xialing95/Open_modem_60Khz/README.md

# Open_Modem
Future Ocean Lab Open Modem Project - Low cost underwater acoustic modem

Documentation: https://dspace.mit.edu/handle/1721.1/130598?show=full
