xialing95/Open_modem_60Khz/OpenModem V2/OpenModemV2_rx.brd

## EAGLE design OpenModem V2/OpenModemV2_rx.brd (2023-05-25)

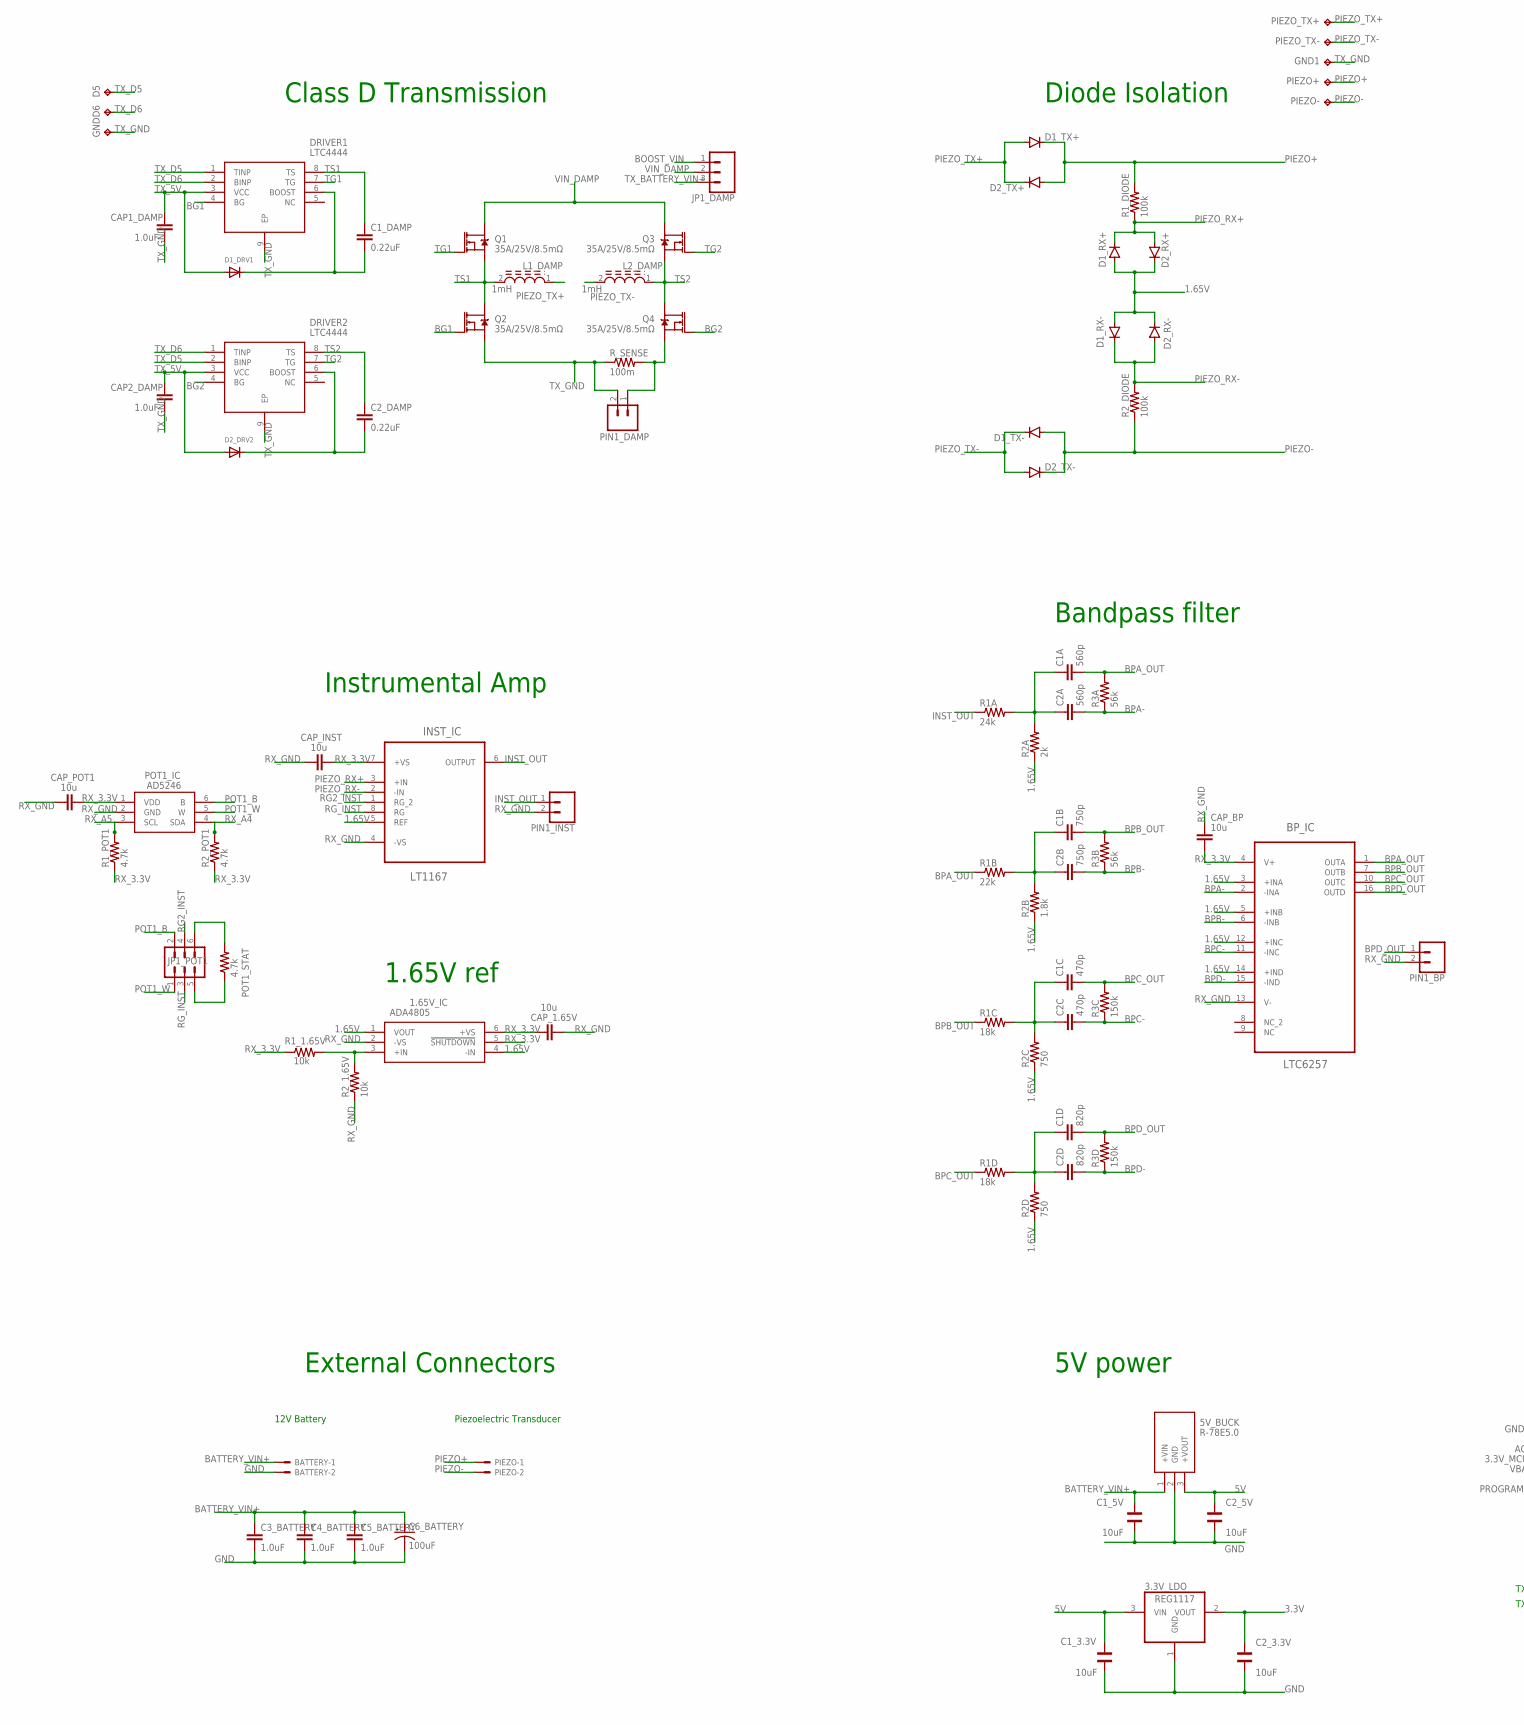
[picture p1: schematic OpenModemV2_rx.sch, sheet 1, part in row 1, column 1]

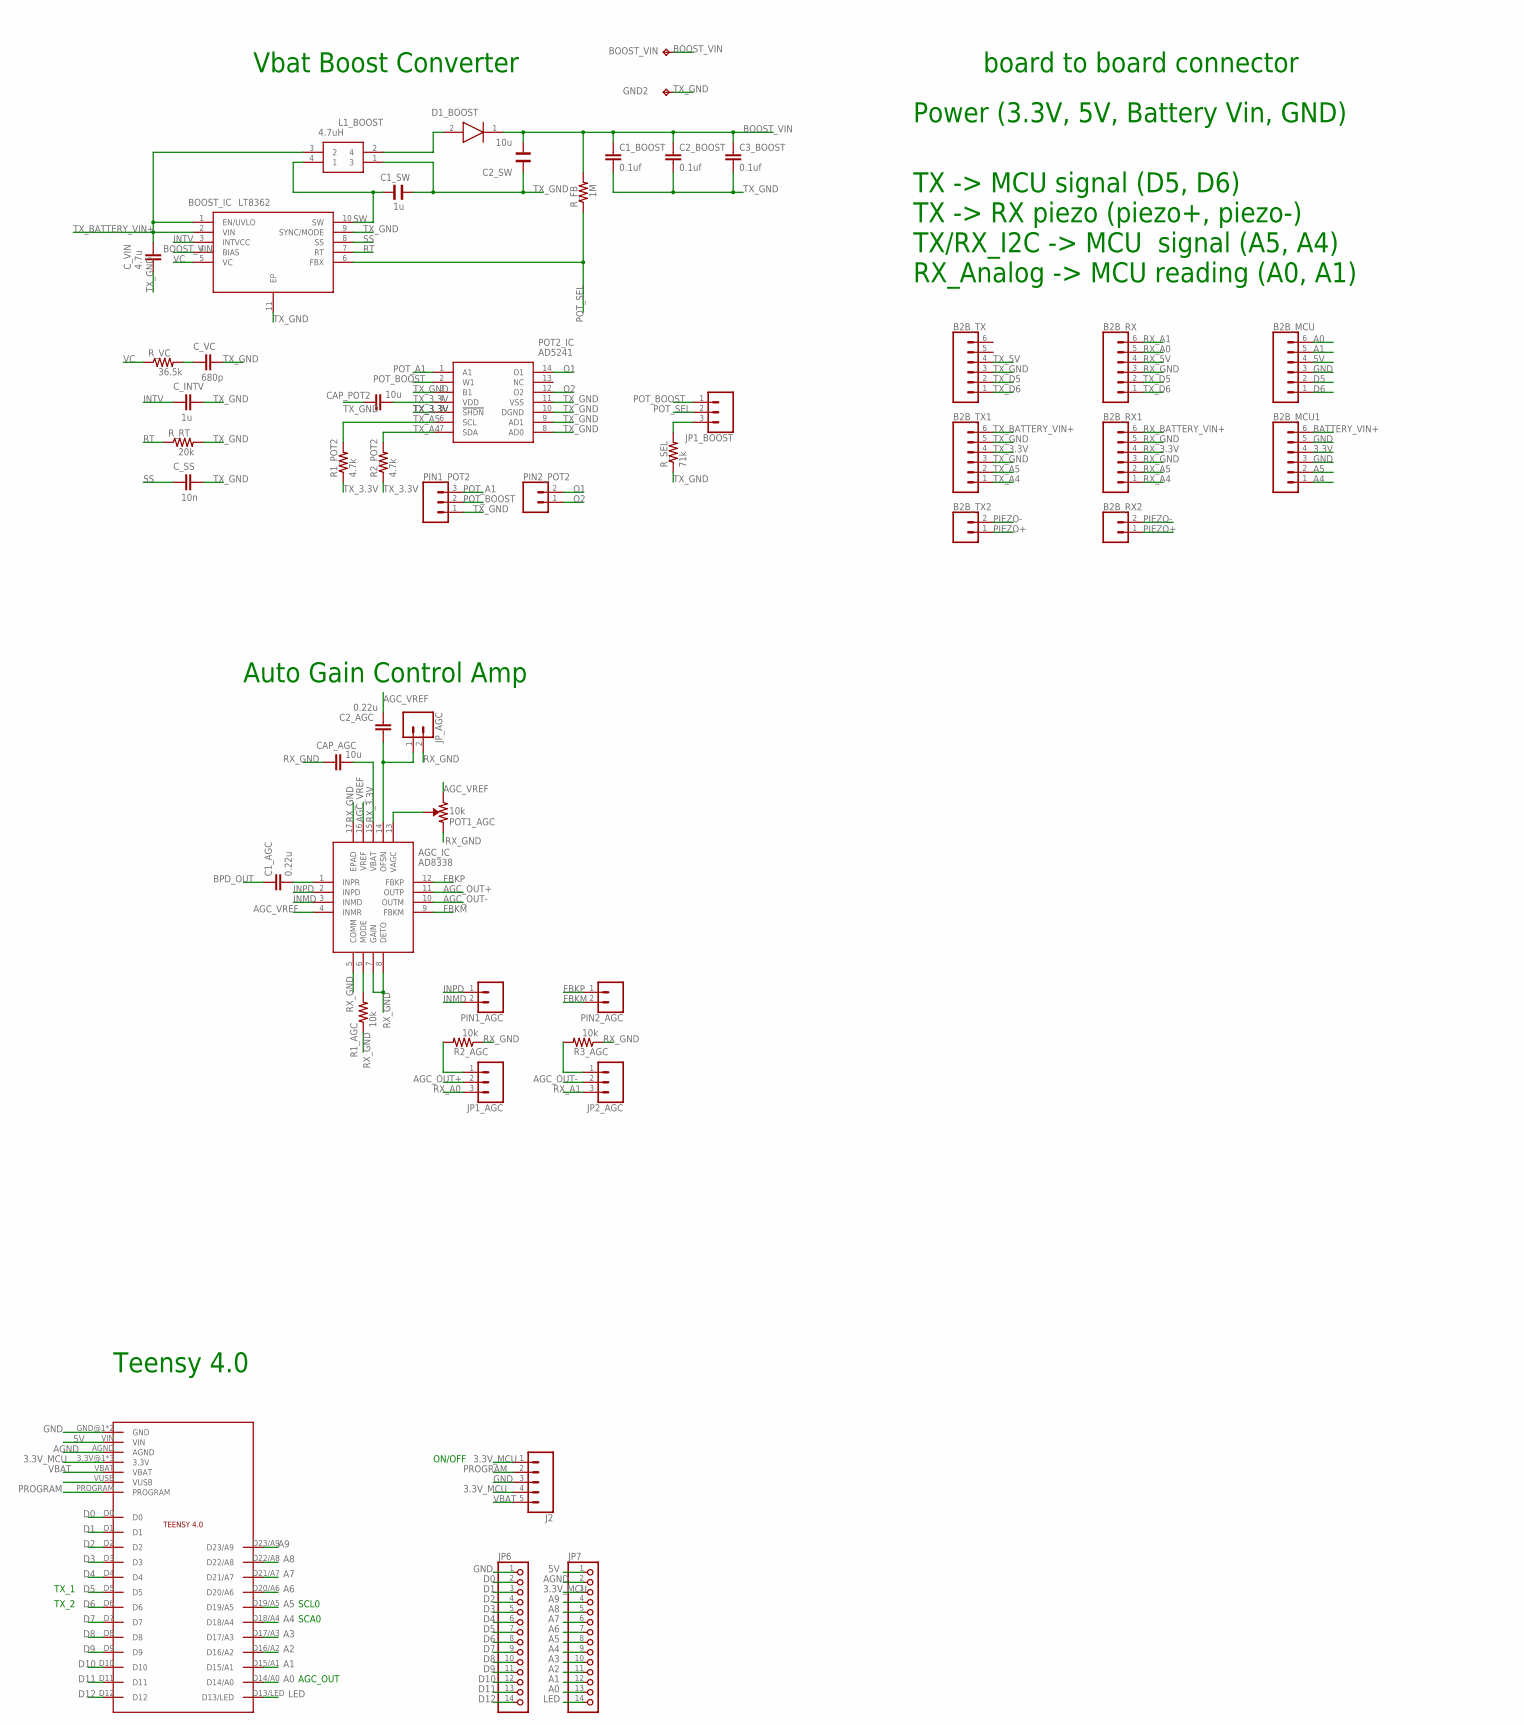
[picture p2: schematic OpenModemV2_rx.sch, sheet 1, part in row 1, column 2]

Parts:
1.65V_IC: ADA4805; SOT95P280X145-6N
3.3V_LDO: REG1117; SOT223
5V_BUCK: R-78E5.0; R-78E5.0-1.0
AGC_IC: AD8338; QFN50P300X300X80-17N
B2B_MCU, B2B_MCU1, B2B_RX, B2B_RX1, B2B_TX, B2B_TX1: CONN_06SILK_FEMALE_PTH; 1X06
B2B_RX2, B2B_TX2: CONN_02; 1X02
BATTERY: 22-27-2021-02; 6410-02
BOOST_IC: LT8362; SON50P300X300X80-11N
BOOST_VIN: TPPAD1-13; P1-13
BP_IC: LTC6257; SOP50P490X110-16N
C1A, C2A: 560p; C0402
C1B, C2B: 750p; C0402
C1C, C2C: 470p; C0402
C1D, C2D: 820p; C0402
C1_3.3V, C1_5V, C2_3.3V, C2_5V: 10uF; WCAP-CSGP_0603_REFLOW
C1_AGC, C2_AGC: 0.22u; C0402
C1_BOOST, C2_BOOST, C3_BOOST: 0.1uf; 0805
C1_DAMP, C2_DAMP: 0.22uF; 0603
C1_SW: 1u; WCAP-CSGP_1206
C2_SW: 10u; WCAP-CSGP_1206
C3_BATTERY, C4_BATTERY, C5_BATTERY: 1.0uF; 0805
C6_BATTERY: 100uF; PANASONIC_D
CAP1_DAMP, CAP2_DAMP: 1.0uF; 0603
CAP_1.65V: 10u; C0402
CAP_AGC: 10u; C0402
CAP_BP: 10u; C0402
CAP_INST: 10u; C0402
CAP_POT1, CAP_POT2: 10u; C0402
C_INTV: 1u; C0402
C_SS: 10n; C0402
C_VC: 680p; C0402
C_VIN: 4.7u; C0402
D1_BOOST: DFLS260-7; POWERDI123
D1_DRV1, D2_DRV2: DIODESOD-323F; SOD-323F
D1_RX+, D1_RX-, D1_TX+, D1_TX-, D2_RX+, D2_RX-, D2_TX+, D2_TX-: DIODE-SOD523; SOD523
D5, D6: TPPAD1-13; P1-13
DRIVER1, DRIVER2: LTC4444; SOP65P490X110-9N
GND, GND1, GND2: TPPAD1-13; P1-13
INST_IC: LT1167; SOIC127P600X175-8N
J2: CONN_05; 1X05
JP1_AGC, JP1_BOOST, JP1_DAMP, JP2_AGC: CONN_03; 1X03
JP1_POT1: CONN_03X2NO_SILK; 2X3-NS
JP6, JP7: PINHD-1X14-CB; 1X14-CB
JP_AGC: CONN_02; 1X02
L1_BOOST: 4.7uH; WE-DD_7332/734512
L1_DAMP, L2_DAMP: 1mH; INDP125125X600N
PIEZO: 22-27-2021-02; 6410-02
PIEZO+: TPPAD1-13; P1-13
PIEZO-: TPPAD1-13; P1-13
PIEZO_TX+: TPPAD1-13; P1-13
PIEZO_TX-: TPPAD1-13; P1-13
PIN1_AGC, PIN1_BP, PIN1_DAMP, PIN1_INST, PIN2_AGC, PIN2_POT2: CONN_02; 1X02
PIN1_POT2: CONN_03; 1X03
POT1_AGC: 10k; TRIMPOT-SMD-3MM-CLOSED
POT1_IC: AD5246; SOT65P210X110-6N
POT1_STAT: 4.7k; R0603
POT2_IC: AD5241; SOP65P640X120-14N
Q1, Q2, Q3, Q4: 35A/25V/8.5mΩ; DPAK
R1A: 24k; R0603
R1B: 22k; R0603
R1C, R1D: 18k; R0603
R1_1.65V, R1_AGC, R2_1.65V, R2_AGC, R3_AGC: 10k; R0603
R1_DIODE, R2_DIODE: 100k; R0603
R1_POT1, R1_POT2, R2_POT1, R2_POT2: 4.7k; R0603
R2A: 2k; R0603
R2B: 1.8k; R0603
R2C, R2D: 750; R0603
R3A, R3B: 56k; R0603
R3C, R3D: 150k; R0603
R_FB: 1M; R0603
R_RT: 20k; R0603
R_SEL: 71k; R0603
R_SENSE: 100m; M1206
R_VC: 36.5k; R0603
U$1: TEENSY4.0

Connections:
1.65V: 1.65V_IC.1 (VOUT), 1.65V_IC.4 (-IN), BP_IC.3 (+INA), BP_IC.5 (+INB), BP_IC.12 (+INC), BP_IC.14 (+IND), D1_RX+.A, D1_RX-.A, D2_RX+.C, D2_RX-.C, INST_IC.5 (REF), R2A.1, R2B.1, R2C.1, R2D.1
3.3V: 3.3V_LDO.2 (VOUT), B2B_MCU1.4, C2_3.3V.2
3.3V_MCU: J2.1, J2.4, JP7.3, U$1.3.3V@1 (3.3V), U$1.3.3V@2 (3.3V), U$1.ON/OFF (3.3V)
5V: 3.3V_LDO.3 (VIN), 5V_BUCK.3 (+VOUT), B2B_MCU.4, C1_3.3V.2, C2_5V.2, JP7.1, U$1.VIN
A0: B2B_MCU.6, JP7.13, U$1.D14/A0
A1: B2B_MCU.5, JP7.12, U$1.D15/A1
A2: JP7.11, U$1.D16/A2
A3: JP7.10, U$1.D17/A3
A4: B2B_MCU1.1, JP7.9, U$1.D18/A4
A5: B2B_MCU1.2, JP7.8, U$1.D19/A5
A6: JP7.7, U$1.D20/A6
A7: JP7.6, U$1.D21/A7
A8: JP7.5, U$1.D22/A8
A9: JP7.4, U$1.D23/A9
AGC_OUT+: AGC_IC.11 (OUTP), JP1_AGC.2
AGC_OUT-: AGC_IC.10 (OUTM), JP2_AGC.2
AGC_VREF: AGC_IC.4 (INMR), AGC_IC.16 (VREF), C2_AGC.2, POT1_AGC.3 (CW)
AGND: JP7.2, U$1.AGND
BATTERY_VIN+: 5V_BUCK.1 (+VIN), B2B_MCU1.6, BATTERY.1, C1_5V.1, C3_BATTERY.1, C4_BATTERY.1, C5_BATTERY.1, C6_BATTERY.+
BG1: DRIVER1.4 (BG), Q2.1 (G)
BG2: DRIVER2.4 (BG), Q4.1 (G)
BOOST_VIN: BOOST_IC.4 (BIAS), BOOST_VIN.TP, C1_BOOST.1, C2_BOOST.1, C2_SW.1, C3_BOOST.1, D1_BOOST.1 (K), JP1_DAMP.1, R_FB.2
BPA-: BP_IC.2 (-INA), C2A.2, R3A.1
BPA_OUT: BP_IC.1 (OUTA), C1A.2, R1B.1, R3A.2
BPB-: BP_IC.6 (-INB), C2B.2, R3B.1
BPB_OUT: BP_IC.7 (OUTB), C1B.2, R1C.1, R3B.2
BPC-: BP_IC.11 (-INC), C2C.2, R3C.1
BPC_OUT: BP_IC.10 (OUTC), C1C.2, R1D.1, R3C.2
BPD-: BP_IC.15 (-IND), C2D.2, R3D.1
BPD_OUT: BP_IC.16 (OUTD), C1D.2, C1_AGC.1, PIN1_BP.1, R3D.2
D0: JP6.2, U$1.D0
D1: JP6.3, U$1.D1
D2: JP6.4, U$1.D2
D3: JP6.5, U$1.D3
D4: JP6.6, U$1.D4
D5: B2B_MCU.2, JP6.7, U$1.D5
D6: B2B_MCU.1, JP6.8, U$1.D6
D7: JP6.9, U$1.D7
D8: JP6.10, U$1.D8
D9: JP6.11, U$1.D9
D10: JP6.12, U$1.D10
D11: JP6.13, U$1.D11
D12: JP6.14, U$1.D12
FBKM: AGC_IC.9 (FBKM), PIN2_AGC.2
FBKP: AGC_IC.12 (FBKP), PIN2_AGC.1
GND: 3.3V_LDO.1 (GND), 5V_BUCK.2 (GND), B2B_MCU.3, B2B_MCU1.3, B2B_MCU1.5, BATTERY.2, C1_3.3V.1, C1_5V.2, C2_3.3V.1, C2_5V.1, C3_BATTERY.2, C4_BATTERY.2, C5_BATTERY.2, C6_BATTERY.-, J2.3, JP6.1, U$1.GND@1 (GND), U$1.GND@2 (GND)
INMD: AGC_IC.3 (INMD), PIN1_AGC.2
INPD: AGC_IC.2 (INPD), PIN1_AGC.1
INST_OUT: INST_IC.6 (OUTPUT), PIN1_INST.1, R1A.1
INTV: BOOST_IC.3 (INTVCC), C_INTV.2
LED: JP7.14, U$1.D13/LED
unnamed: C1_DAMP.2, D1_DRV1.C, DRIVER1.6 (BOOST)
unnamed: C2_DAMP.2, D2_DRV2.C, DRIVER2.6 (BOOST)
unnamed: JP1_POT1.6, POT1_STAT.2
unnamed: C1A.1, C2A.1, R1A.2, R2A.2
unnamed: C1B.1, C2B.1, R1B.2, R2B.2
unnamed: C1C.1, C2C.1, R1C.2, R2C.2
unnamed: C1D.1, C2D.1, R1D.2, R2D.2
unnamed: C_VC.2, R_VC.2
unnamed: AGC_IC.6 (MODE), R1_AGC.2
unnamed: 1.65V_IC.3 (+IN), R1_1.65V.2, R2_1.65V.2
unnamed: AGC_IC.1 (INPR), C1_AGC.2
unnamed: JP1_POT1.5, POT1_STAT.1
unnamed: JP1_AGC.1, R2_AGC.2
unnamed: JP2_AGC.1, R3_AGC.2
unnamed: AGC_IC.14 (OFSN), C2_AGC.1, JP_AGC.1
unnamed: AGC_IC.13 (VAGC), POT1_AGC.2 (WIPER)
unnamed: PIN1_DAMP.1, Q4.3 (S), R_SENSE.2
unnamed: D1_BOOST.2 (A), L1_BOOST.2 (4)
unnamed: JP1_BOOST.3, R_SEL.2
O1: PIN2_POT2.2, POT2_IC.14 (O1)
O2: PIN2_POT2.1, POT2_IC.12 (O2)
PIEZO+: B2B_RX2.1, B2B_TX2.1, D1_TX+.C, D2_TX+.A, PIEZO.1, PIEZO+.TP, R1_DIODE.2
PIEZO-: B2B_RX2.2, B2B_TX2.2, D1_TX-.A, D2_TX-.C, PIEZO.2, PIEZO-.TP, R2_DIODE.1
PIEZO_RX+: D1_RX+.C, D2_RX+.A, INST_IC.3 (+IN), R1_DIODE.1
PIEZO_RX-: D1_RX-.C, D2_RX-.A, INST_IC.2 (-IN), R2_DIODE.2
PIEZO_TX+: D1_TX+.A, D2_TX+.C, L1_DAMP.1, PIEZO_TX+.TP
PIEZO_TX-: D1_TX-.C, D2_TX-.A, L2_DAMP.2, PIEZO_TX-.TP
POT1_B: JP1_POT1.2, POT1_IC.6 (B)
POT1_W: JP1_POT1.1, POT1_IC.5 (W)
POT_A1: PIN1_POT2.3, POT2_IC.1 (A1)
POT_BOOST: JP1_BOOST.1, PIN1_POT2.2, POT2_IC.2 (W1)
POT_SEL: BOOST_IC.6 (FBX), JP1_BOOST.2, R_FB.1
PROGRAM: J2.2, U$1.PROGRAM
RG2_INST: INST_IC.1 (RG_2), JP1_POT1.4
RG_INST: INST_IC.8 (RG), JP1_POT1.3
RT: BOOST_IC.7 (RT), R_RT.1
RX_3.3V: 1.65V_IC.5 (!SHUTDOWN), 1.65V_IC.6 (+VS), AGC_IC.15 (VBAT), B2B_RX1.4, BP_IC.4 (V+), CAP_1.65V.2, CAP_AGC.1, CAP_BP.1, CAP_INST.2, CAP_POT1.2, INST_IC.7 (+VS), POT1_IC.1 (VDD), R1_1.65V.1, R1_POT1.1, R2_POT1.1
RX_5V: B2B_RX.4
RX_A0: B2B_RX.5, JP1_AGC.3
RX_A1: B2B_RX.6, JP2_AGC.3
RX_A4: B2B_RX1.1, POT1_IC.4 (SDA), R2_POT1.2
RX_A5: B2B_RX1.2, POT1_IC.3 (SCL), R1_POT1.2
RX_BATTERY_VIN+: B2B_RX1.6
RX_GND: 1.65V_IC.2 (-VS), AGC_IC.5 (COMM), AGC_IC.7 (GAIN), AGC_IC.8 (DETO), AGC_IC.17 (EPAD), B2B_RX.3, B2B_RX1.3, B2B_RX1.5, BP_IC.13 (V-), CAP_1.65V.1, CAP_AGC.2, CAP_BP.2, CAP_INST.1, CAP_POT1.1, INST_IC.4 (-VS), JP_AGC.2, PIN1_BP.2, PIN1_INST.2, POT1_AGC.1 (CCW), POT1_IC.2 (GND), R1_AGC.1, R2_1.65V.1, R2_AGC.1, R3_AGC.1
SS: BOOST_IC.8 (SS), C_SS.2
SW: BOOST_IC.10 (SW), C1_SW.2, L1_BOOST.4 (1)
TG1: DRIVER1.7 (TG), Q1.1 (G)
TG2: DRIVER2.7 (TG), Q3.1 (G)
TS1: C1_DAMP.1, DRIVER1.8 (TS), L1_DAMP.2, Q1.3 (S), Q2.4 (D)
TS2: C2_DAMP.1, DRIVER2.8 (TS), L2_DAMP.1, Q3.3 (S), Q4.4 (D)
TX_3.3V: B2B_TX1.4, CAP_POT2.1, POT2_IC.4 (VDD), POT2_IC.5 (!SHDN), R1_POT2.1, R2_POT2.1
TX_5V: B2B_TX.4, CAP1_DAMP.1, CAP2_DAMP.1, D1_DRV1.A, D2_DRV2.A, DRIVER1.3 (VCC), DRIVER2.3 (VCC)
TX_A4: B2B_TX1.1, POT2_IC.7 (SDA), R2_POT2.2
TX_A5: B2B_TX1.2, POT2_IC.6 (SCL), R1_POT2.2
TX_BATTERY_VIN+: B2B_TX1.6, BOOST_IC.1 (EN/UVLO), BOOST_IC.2 (VIN), C_VIN.2, JP1_DAMP.3, L1_BOOST.3 (2)
TX_D5: B2B_RX.2, B2B_TX.2, D5.TP, DRIVER1.1 (TINP), DRIVER2.2 (BINP)
TX_D6: B2B_RX.1, B2B_TX.1, D6.TP, DRIVER1.2 (BINP), DRIVER2.1 (TINP)
TX_GND: B2B_TX.3, B2B_TX1.3, B2B_TX1.5, BOOST_IC.9 (SYNC/MODE), BOOST_IC.11 (EP), C1_BOOST.2, C1_SW.1, C2_BOOST.2, C2_SW.2, C3_BOOST.2, CAP1_DAMP.2, CAP2_DAMP.2, CAP_POT2.2, C_INTV.1, C_SS.1, C_VC.1, C_VIN.1, DRIVER1.9 (EP), DRIVER2.9 (EP), GND.TP, GND1.TP, GND2.TP, L1_BOOST.1 (3), PIN1_DAMP.2, PIN1_POT2.1, POT2_IC.3 (B1), POT2_IC.8 (AD0), POT2_IC.9 (AD1), POT2_IC.10 (DGND), POT2_IC.11 (VSS), Q2.3 (S), R_RT.2, R_SEL.1, R_SENSE.1
VBAT: J2.5, U$1.VBAT
VC: BOOST_IC.5 (VC), R_VC.1
VIN_DAMP: JP1_DAMP.2, Q1.4 (D), Q3.4 (D)

Notes on the sheet:
Class D Transmission
Instrumental Amp
Bandpass filter
Auto Gain Control Amp
Teensy 4.0
5V power
Diode Isolation
1.65V ref
Vbat Boost Converter
SCL0
SCA0
TX_1
TX_2
AGC_OUT
External Connectors
12V Battery
Piezoelectric Transducer
board to board connector
Power (3.3V, 5V, Battery Vin, GND)
TX -> MCU signal (D5, D6) TX -> RX piezo (piezo+, piezo-) TX/RX_I2C -> MCU signal (A5, A4) RX_Analog -> MCU reading (A0, A1)
ON/OFF

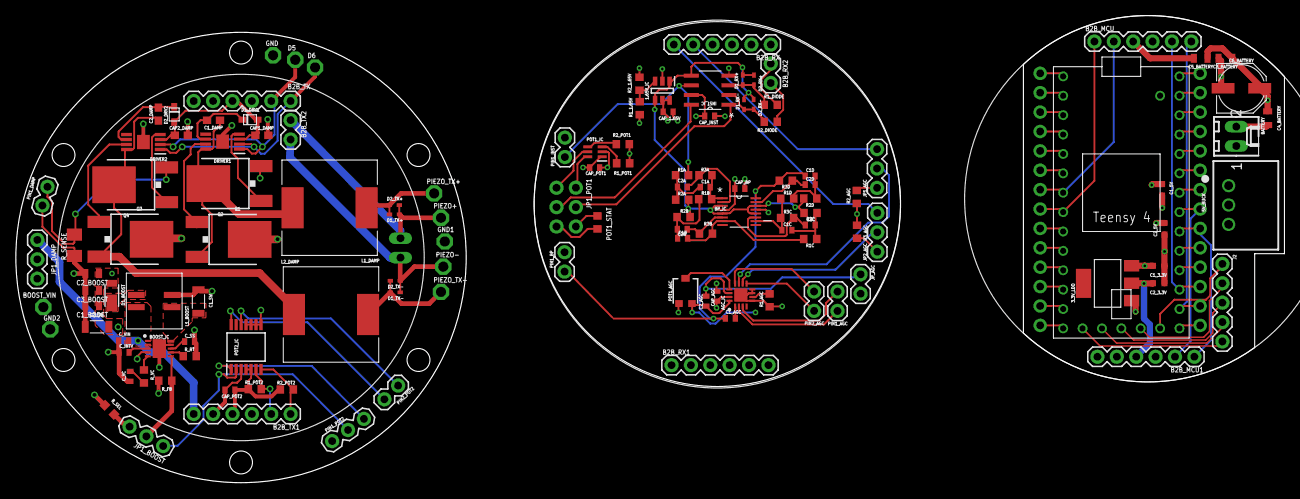
[picture p3: board OpenModemV2_rx.brd from above]

Board: 4 copper layers, 166.2 x 61.2 mm, 133 parts (1 on the bottom side), 110 nets.
