xialing95/Open_modem_60Khz/(notices)

Notices in the files:
parts and their libraries:
Wurth_Elektronik_Passive_Capacitors_rev1: Copyright: Würth Elektronik
SparkFun-Capacitors: Licensing: Creative Commons ShareAlike 4.0 International - https://creativecommons.org/licenses/by-sa/4.0
